CameronParrettUKY/Delta-Trash/README.md

This repository contains code and cad files for the Delta Trash Robot for UKY EE490/EE491 Senior Design.
