CameronParrettUKY/Delta-Trash/Control System/Circuit Schematics/Circuit schematic.jpg

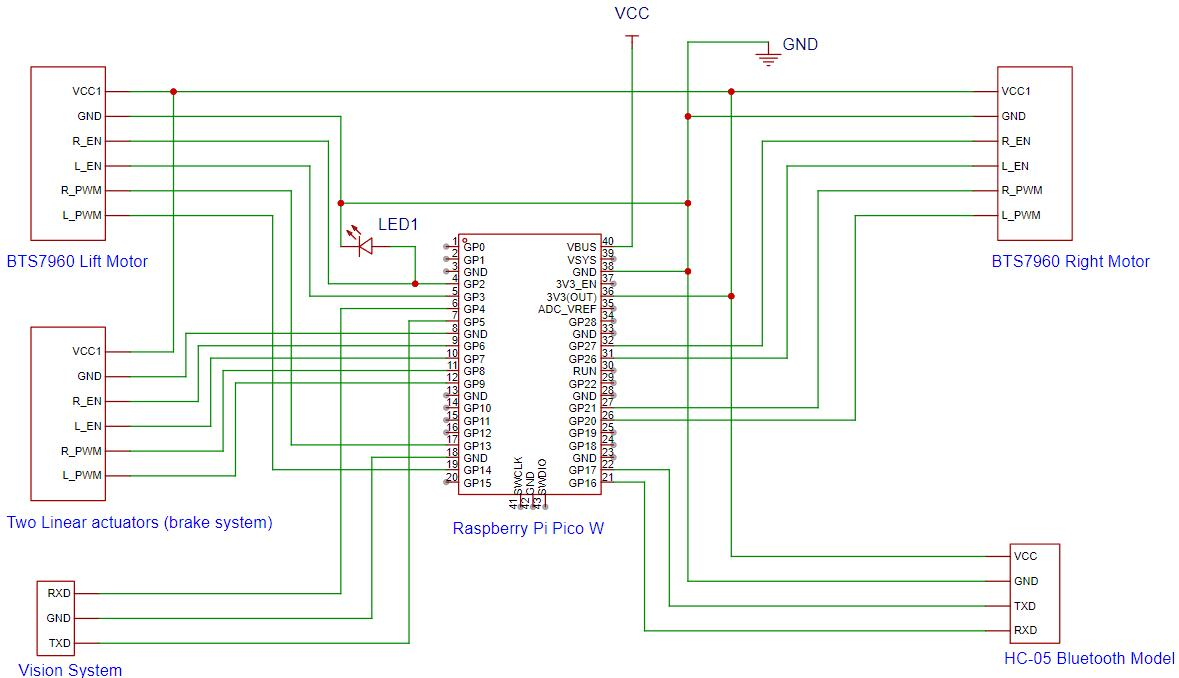
Control System/Circuit Schematics/Circuit schematic.jpg
