CameronParrettUKY/Delta-Trash/Power System/Cad Files/Plugtmp.stl

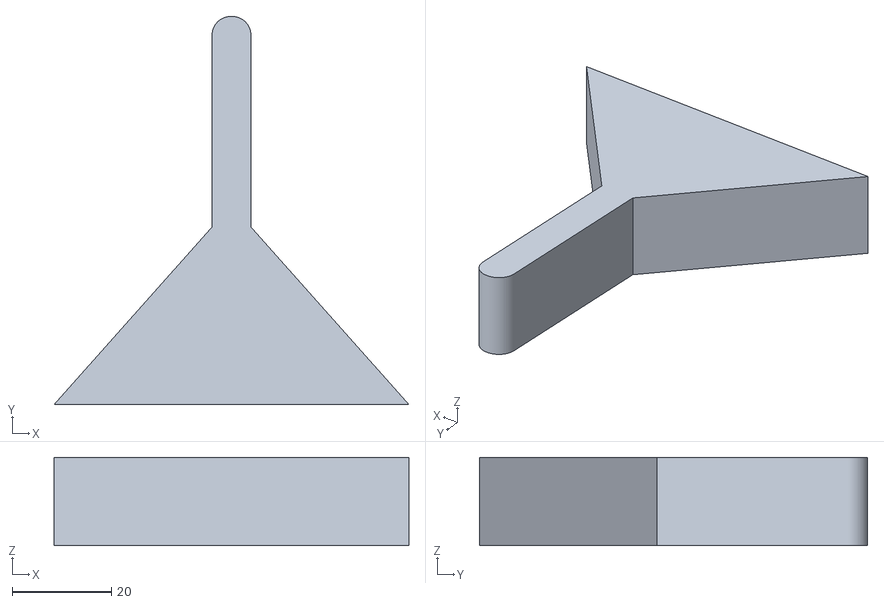
[picture p2: CAD file, 2024-02-24]
Power System/Cad Files/Plugtmp.stl
71.6 x 78.3 x 17.8
