CameronParrettUKY/Delta-Trash/Power System/Cad Files/Receptacletmp.stl

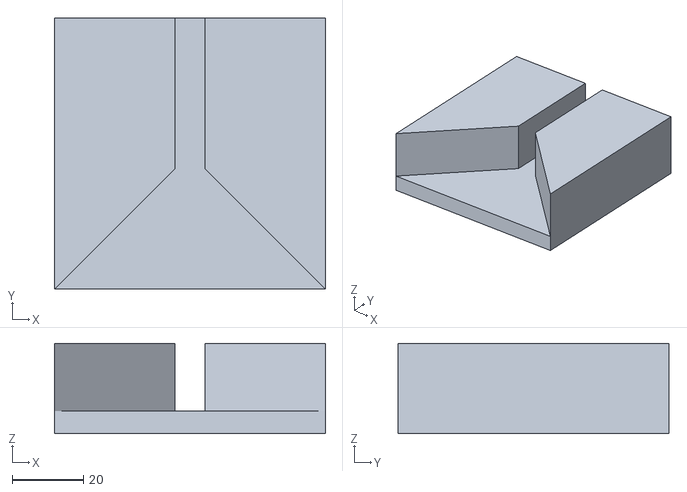
[picture p3: CAD file, 2024-02-24]
Power System/Cad Files/Receptacletmp.stl
76.2 x 76.2 x 25.4
