CameronParrettUKY/Delta-Trash/(list of files, drawings)

Other design files:
Control System/Circuit Schematics/1_P1.schdoc.schdoc
Control System/Circuit Schematics/PCB1.pcbdoc
