CameronParrettUKY/Delta-Trash/Power System/Circuit Schematics/powerboard/powerboard.kicad_pcb

## KiCad design Schematics/KiCad/KiCadTest1/KiCadTest1.sch

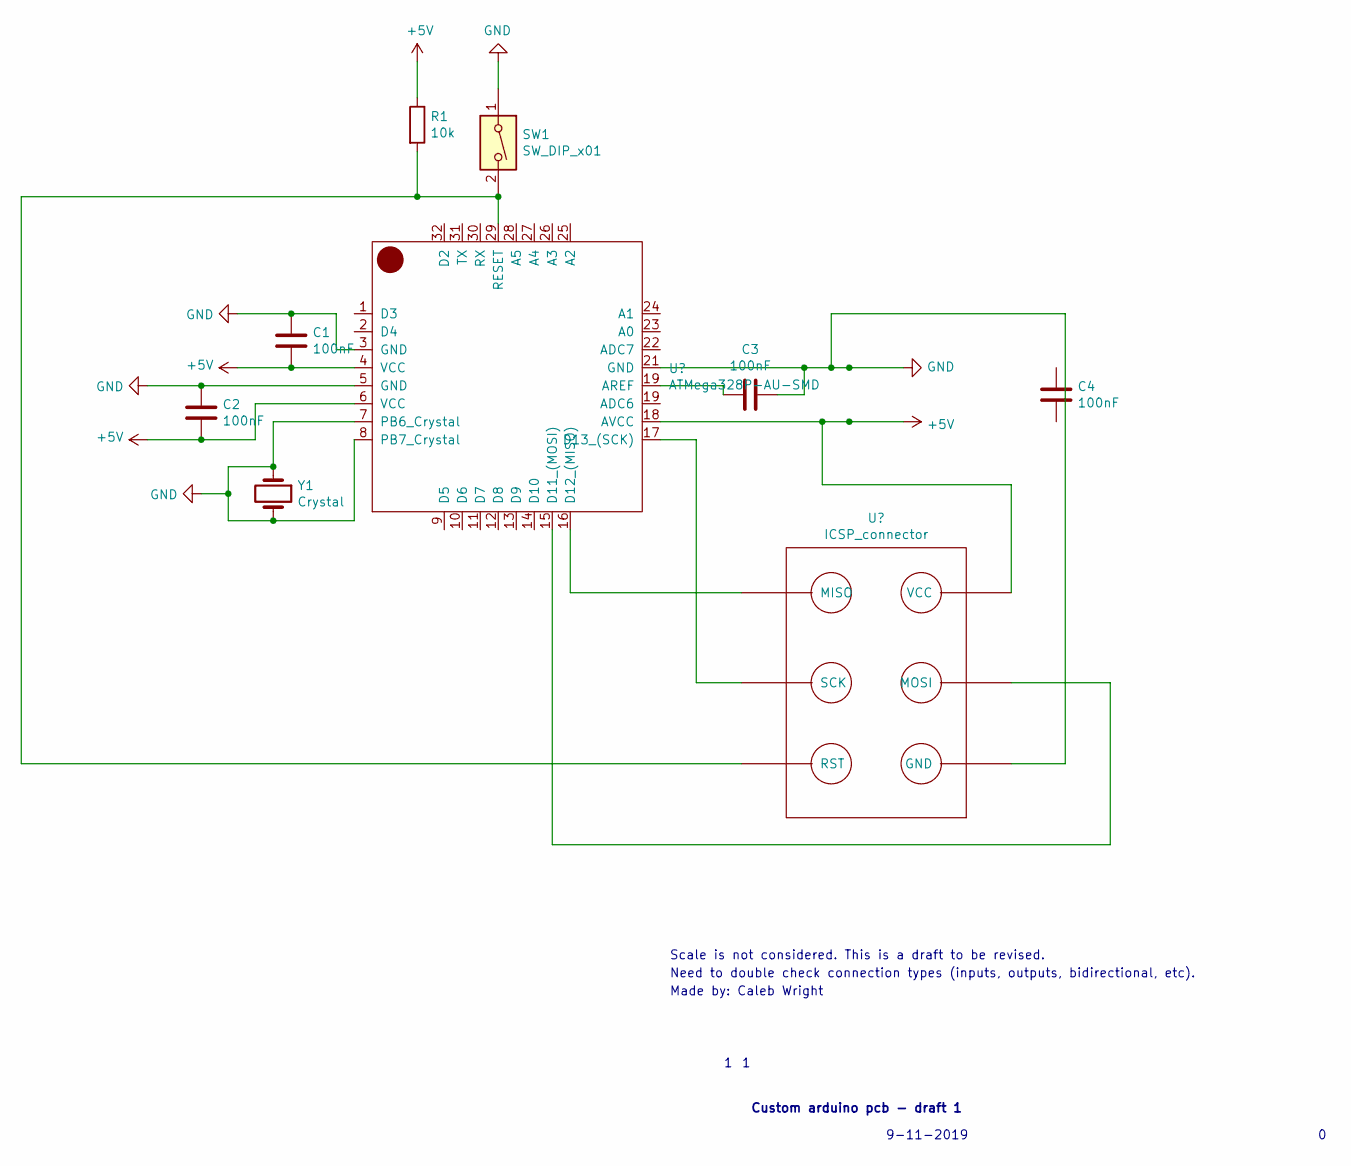
[picture p4: schematic KiCadTest1.sch]

Parts:
C1, C2, C3, C4: 100nF
R1: 10k
SW1: SW_DIP_x01
Y1: Crystal

Connections:
+5V: C1.2, C2.2, R1.1
GND: C1.1, C2.1, C3.1, SW1.1, Y1.1, Y1.2
unnamed: R1.2, SW1.2

Notes on the sheet:
Custom arduino pcb - draft 1
Scale is not considered. This is a draft to be revised.
Need to double check connection types (inputs, outputs, bidirectional, etc).
9-11-2019
Made by: Caleb Wright
