CameronParrettUKY/Delta-Trash/(commit log)

2024-02-24 Uploading Plug system temp models
    plug system demo models
    [Plugtmp.stl, Receptacletmp.stl]
2024-02-24 Powerboard current schematics
    publishing current KICAD drawings
    [Movement Controller.sch, RasPi.sch, file65C086DE.sch, powerboard.kicad_pcb, powerboard.sch]
2024-02-24 moving folder structure
    moving cad files
    [Plugtmp.stl, Receptacletmp.stl]
2024-02-24 Kicad Update to 8.0
    converted project files
    [powerboard.kicad_sch]
2024-02-24 update pcb
    [powerboard.sch]
2024-02-24 powerboard fixes
    [powerboard.kicad_sch]
2024-02-24 powerboard fixes
    more powerboard fixes for file formatting
    [powerboard.kicad_sch]
2024-04-18 Update Schematics
    Update Schematics
    [powerboard.sch]
